vluncasu/power-supply-cases/cases/README.md

# Enclosure files

| Case | Supply | Print files |
|---|---|---|
| [Delta iMac 27″ Late 2015 Power Supply](imac-27-5k-2015/) | Delta ADP-300AF T · iMac 27-inch Retina 5K (Late 2015) | [STL and 3MF](imac-27-5k-2015/print/) |
| [AURA S-60-12](aura-s60/) | Metal S-60-12 · 86 × 58.02 × 33.02 mm STEP reference | [STL and 3MF](aura-s60/print/) |
| [AURA Compact 160](aura-compact-160/) | Metal housing · 110 × 98–100 × 35–36 mm photographic estimate | [STL and 3MF](aura-compact-160/print/) |
| [Suncronizer](suncronizer/) | Solar tracker demo · 104 × 57–58 × 26 mm supply and separate DC converter | [STL and 3MF](suncronizer/print/) |

[View all assembly galleries and print instructions on the project home page](../README.md)
