vluncasu/power-supply-cases/cases/aura-s60/renders/interior.png

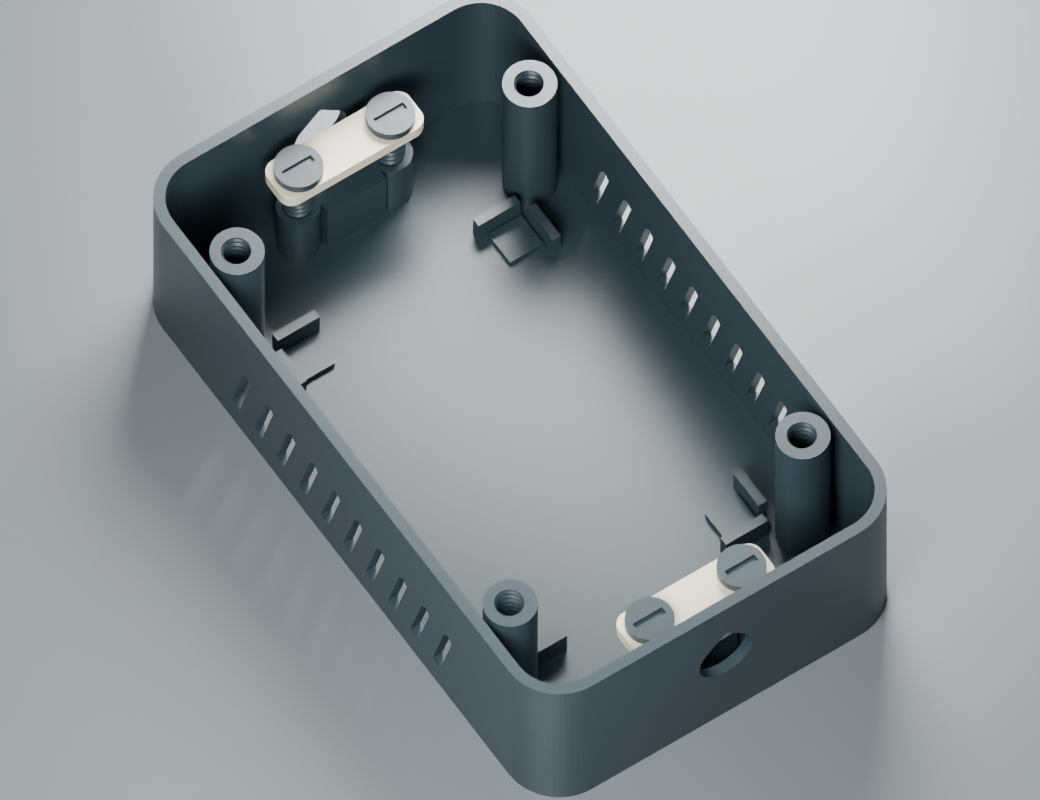
cases/aura-s60/renders/interior.png
