vluncasu/power-supply-cases/cases/aura-compact-160/cad/cable-clamp.step

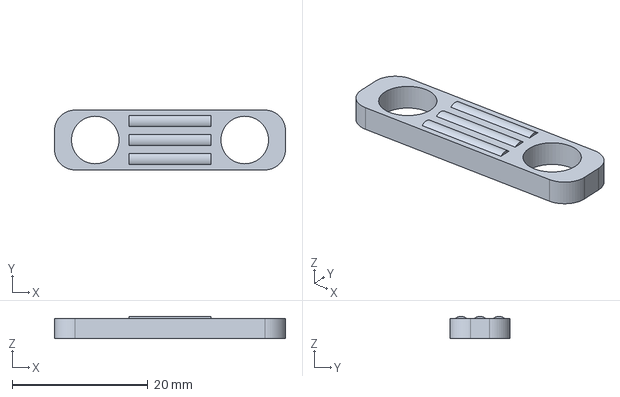
[picture p35: CAD file, 2026-11-08]
cases/aura-compact-160/cad/cable-clamp.step
34.0 x 8.80 x 3.30 mm
