vluncasu/power-supply-cases/cases/aura-compact-160/print/plates/02-white-9.3mf

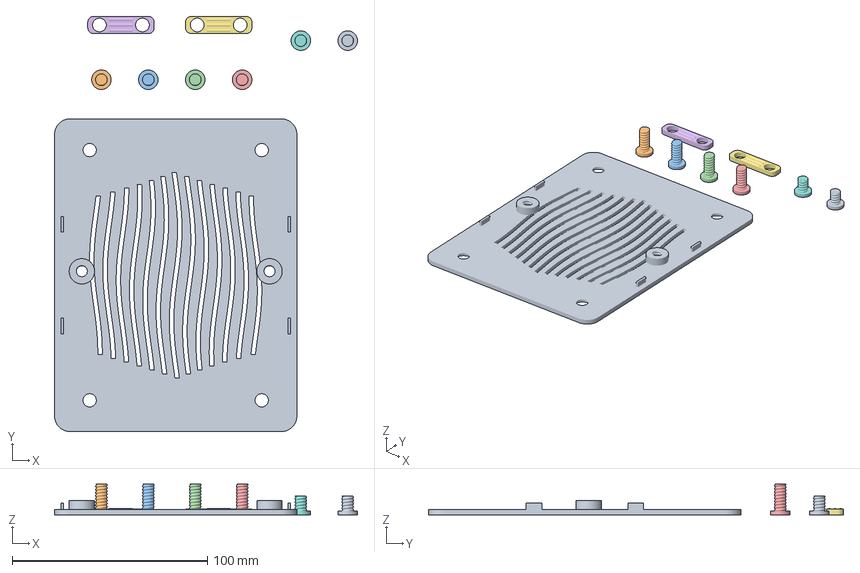
[picture p36: CAD file, 2026-11-08]
cases/aura-compact-160/print/plates/02-white-9.3mf
155.0 x 212.4 x 15.8 mm
02_WHITE_wave_lid_x1
03_WHITE_closure_x4 x 4
04_WHITE_cable_clamp_x2 x 2
06_WHITE_housing_pressure_x2 x 2
