vluncasu/power-supply-cases/cases/aura-compact-160/print/stl/black/01_body_x1.stl

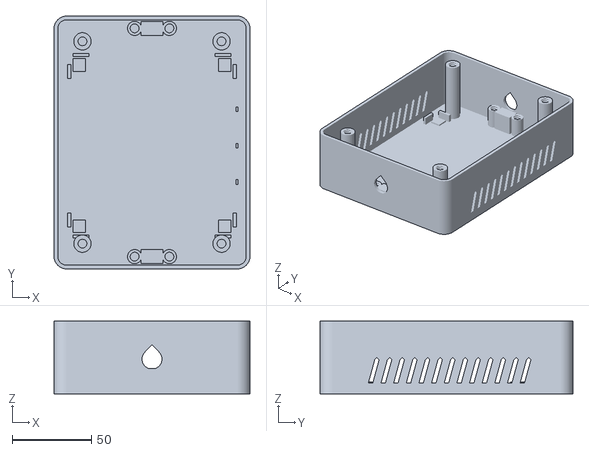
[picture p37: CAD file, 2026-11-08]
cases/aura-compact-160/print/stl/black/01_body_x1.stl
124.0 x 160.0 x 46.0
