vluncasu/power-supply-cases/cases/aura-s60/cad/lid.step

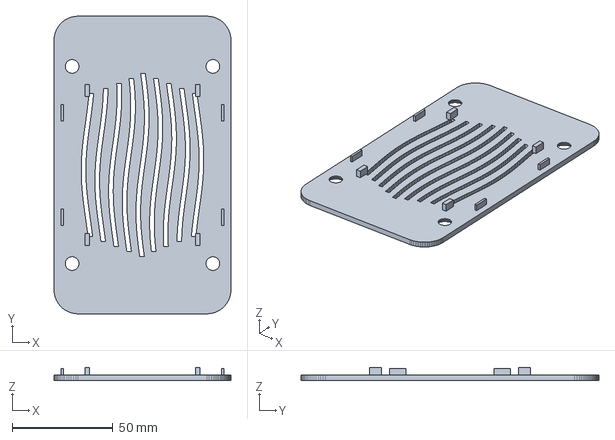
[picture p38: CAD file, 2026-11-08]
cases/aura-s60/cad/lid.step
88.0 x 148.0 x 6.60 mm
