vluncasu/power-supply-cases/cases/aura-s60/print/plates/02-ivory-7.3mf

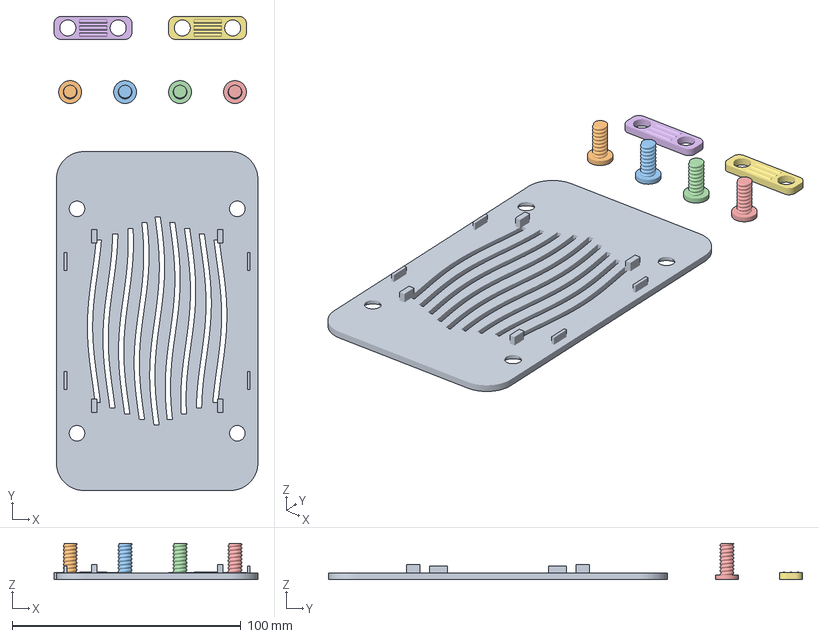
[picture p39: CAD file, 2026-11-08]
cases/aura-s60/print/plates/02-ivory-7.3mf
89.0 x 207.0 x 15.8 mm
02_IVORY_wave_lid_x1
03_IVORY_closure_x4 x 4
04_IVORY_cable_clamp_x2 x 2
