vluncasu/power-supply-cases/cases/aura-s60/print/stl/graphite/01_body_x1.stl

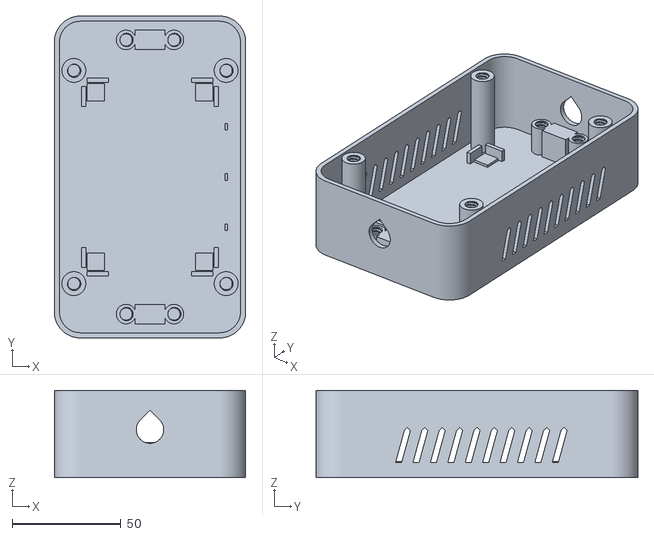
[picture p40: CAD file, 2026-11-08]
cases/aura-s60/print/stl/graphite/01_body_x1.stl
88.0 x 148.0 x 40.0
