vluncasu/power-supply-cases/cases/imac-27-5k-2015/cad/lid.step

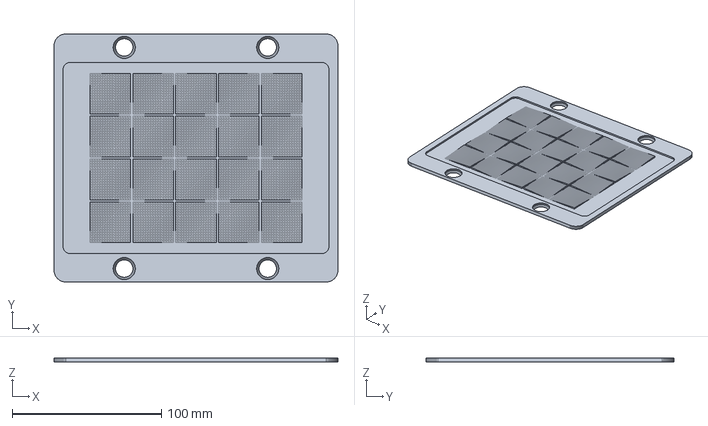
[picture p41: CAD file, 2026-11-08]
cases/imac-27-5k-2015/cad/lid.step
190.0 x 166.0 x 3.00 mm
