vluncasu/power-supply-cases/cases/imac-27-5k-2015/print/plates/01-graphite-13.3mf

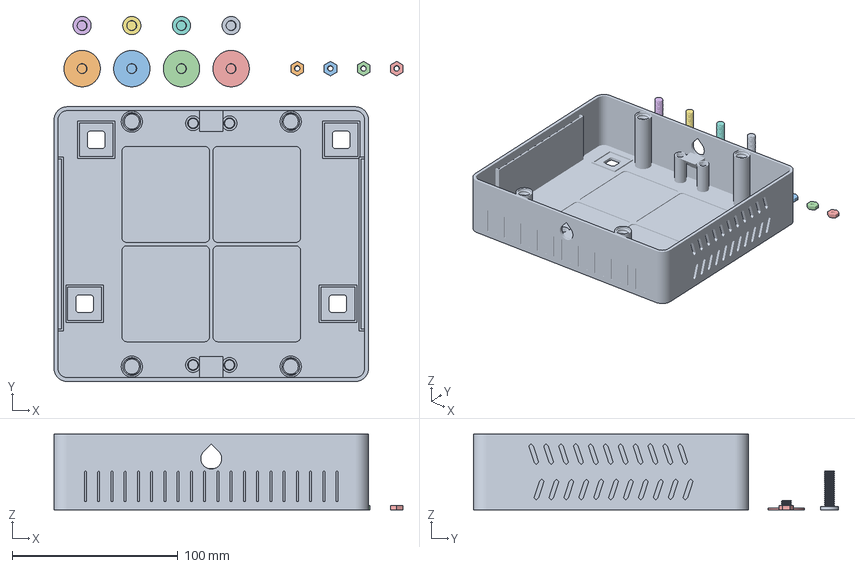
[picture p42: CAD file, 2026-11-08]
cases/imac-27-5k-2015/print/plates/01-graphite-13.3mf
210.8 x 220.5 x 45.8 mm
01_SLIM_BASE
05_MOUNT_LOCK_FOOT_x4 x 4
08_CABLE_CLAMP_SCREW_x4 x 4
06_PCB_NUT_x4 x 4
