vluncasu/power-supply-cases/cases/imac-27-5k-2015/print/stl/ivory/07_cable-clamp_x2.stl

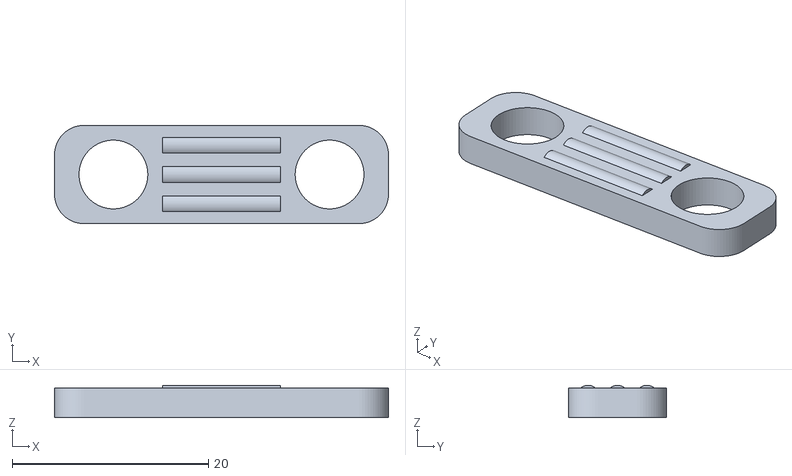
[picture p43: CAD file, 2026-11-08]
cases/imac-27-5k-2015/print/stl/ivory/07_cable-clamp_x2.stl
34.0 x 10.0 x 3.30
