vluncasu/power-supply-cases/cases/suncronizer/print/plates/02-green-7.3mf

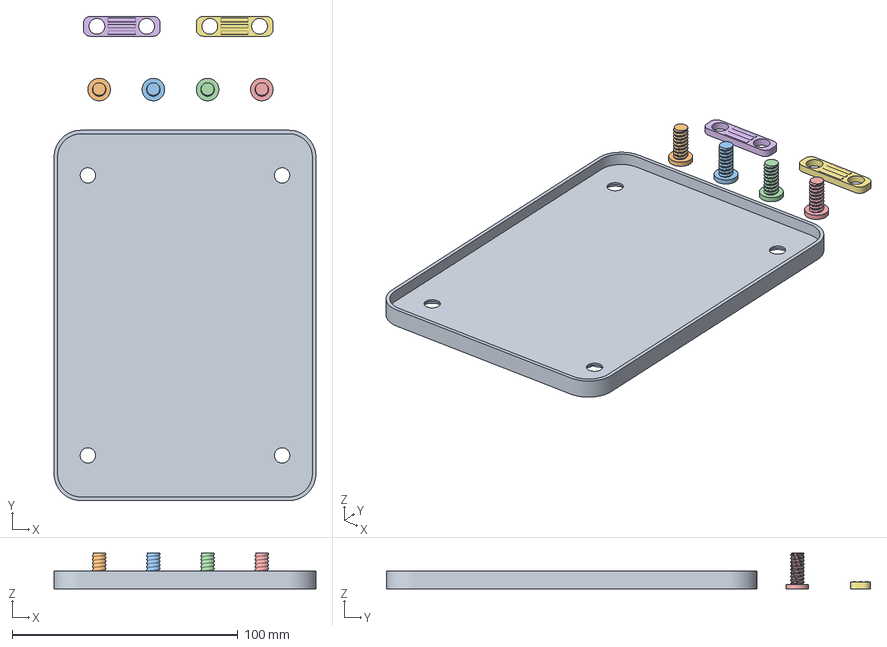
[picture p44: CAD file, 2026-11-08]
cases/suncronizer/print/plates/02-green-7.3mf
116.0 x 214.4 x 15.8 mm
02_GREEN_solar_cap_x1
03_GREEN_closure_x4 x 4
04_GREEN_cable_clamp_x2 x 2
