vluncasu/power-supply-cases/cases/suncronizer/print/stl/black/01_body_x1.stl

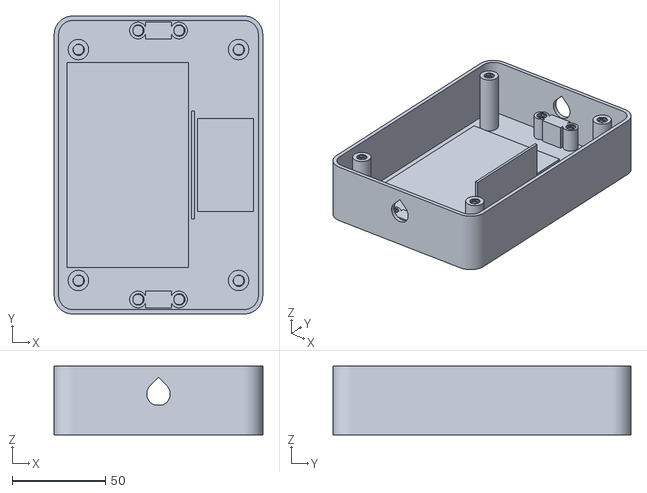
[picture p45: CAD file, 2026-11-08]
cases/suncronizer/print/stl/black/01_body_x1.stl
112.0 x 160.0 x 37.0
