vluncasu/power-supply-cases/cases/aura-compact-160/cad/lid.step

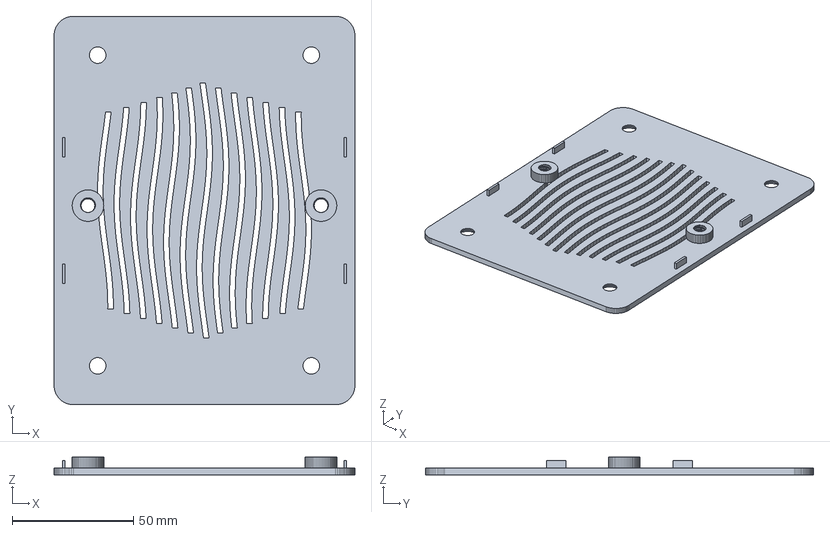
[picture p46: CAD file, 2026-11-08]
cases/aura-compact-160/cad/lid.step
124.0 x 160.0 x 7.40 mm
