vluncasu/power-supply-cases/cases/aura-compact-160/print/plates/01-black-5.3mf

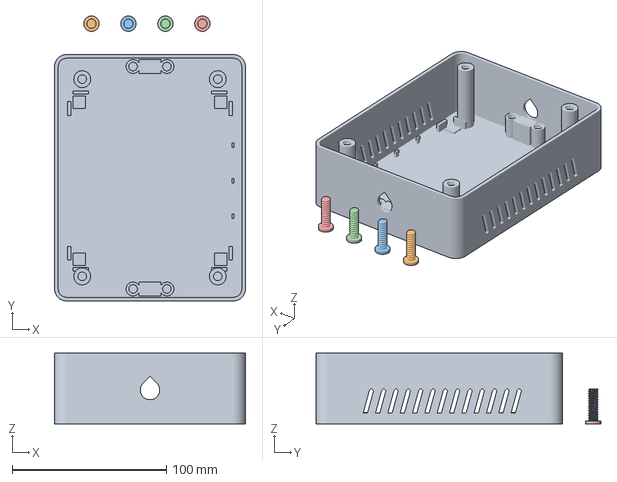
[picture p47: CAD file, 2026-11-08]
cases/aura-compact-160/print/plates/01-black-5.3mf
124.0 x 185.0 x 46.0 mm
01_BLACK_body_x1
05_BLACK_clamp_screw_x4 x 4
