vluncasu/power-supply-cases/cases/aura-s60/print/plates/01-graphite-5.3mf

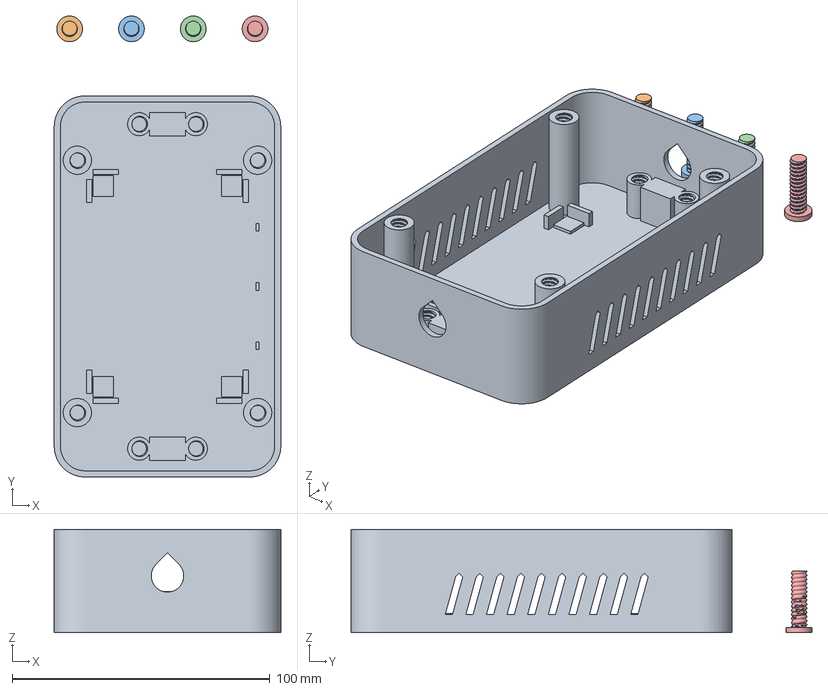
[picture p48: CAD file, 2026-11-08]
cases/aura-s60/print/plates/01-graphite-5.3mf
88.0 x 179.0 x 40.0 mm
01_GRAPHITE_body_x1
05_GRAPHITE_clamp_screw_x4 x 4
