vluncasu/power-supply-cases/cases/imac-27-5k-2015/print/plates/02-ivory-11.3mf

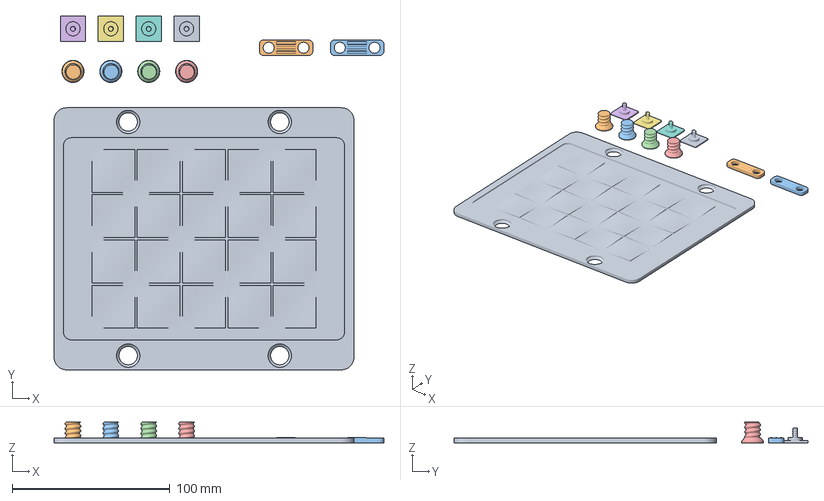
[picture p49: CAD file, 2026-11-08]
cases/imac-27-5k-2015/print/plates/02-ivory-11.3mf
209.0 x 224.0 x 13.0 mm
02_SLIM_LID_exterior_up
03_CLOSURE_SCREW_x4 x 4
04_XY_MOUNT_x4 x 4
07_CABLE_CLAMP_x2_print_flat_side_down x 2
