vluncasu/power-supply-cases/cases/imac-27-5k-2015/print/stl/ivory/04_xy-pcb-support_x4.stl

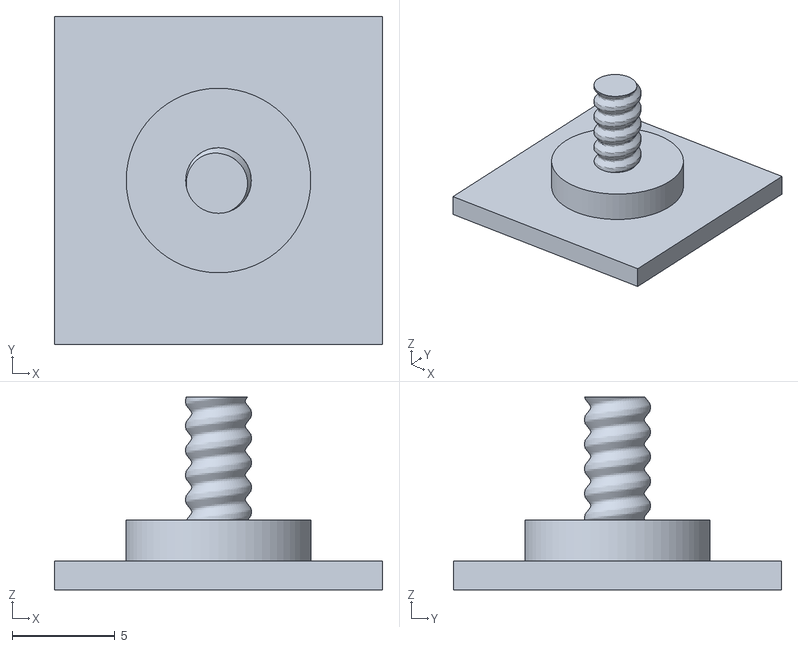
[picture p50: CAD file, 2026-11-08]
cases/imac-27-5k-2015/print/stl/ivory/04_xy-pcb-support_x4.stl
16.0 x 16.0 x 9.40
