vluncasu/power-supply-cases/cases/suncronizer/cad/lid.step

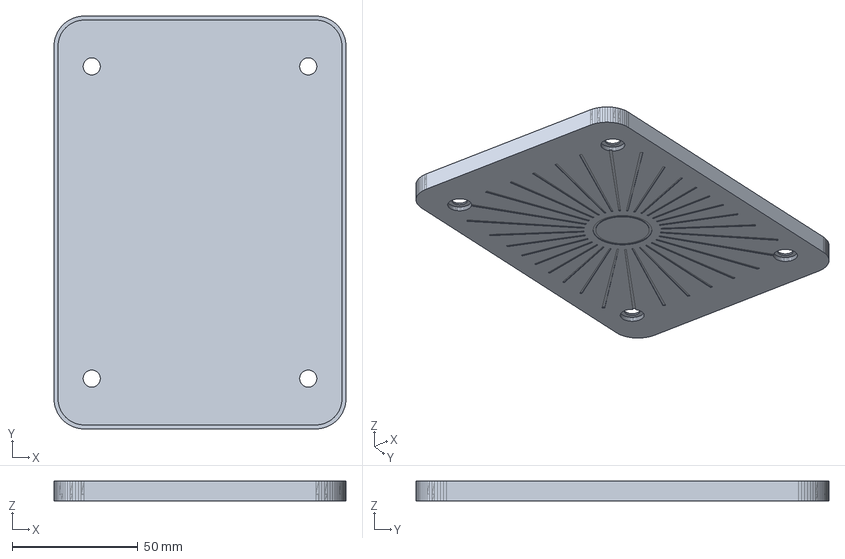
[picture p51: CAD file, 2026-11-08]
cases/suncronizer/cad/lid.step
116.0 x 164.0 x 7.80 mm
