vluncasu/power-supply-cases/cases/suncronizer/print/plates/01-black-5.3mf

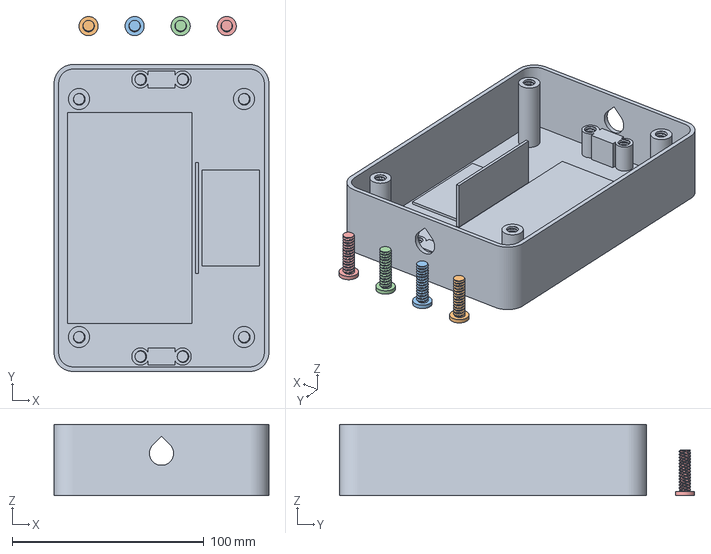
[picture p52: CAD file, 2026-11-08]
cases/suncronizer/print/plates/01-black-5.3mf
112.0 x 185.0 x 37.0 mm
01_BLACK_body_x1
05_BLACK_clamp_screw_x4 x 4
