vluncasu/power-supply-cases/cases/imac-27-5k-2015/print/stl/graphite/05_locking-foot_x4.stl

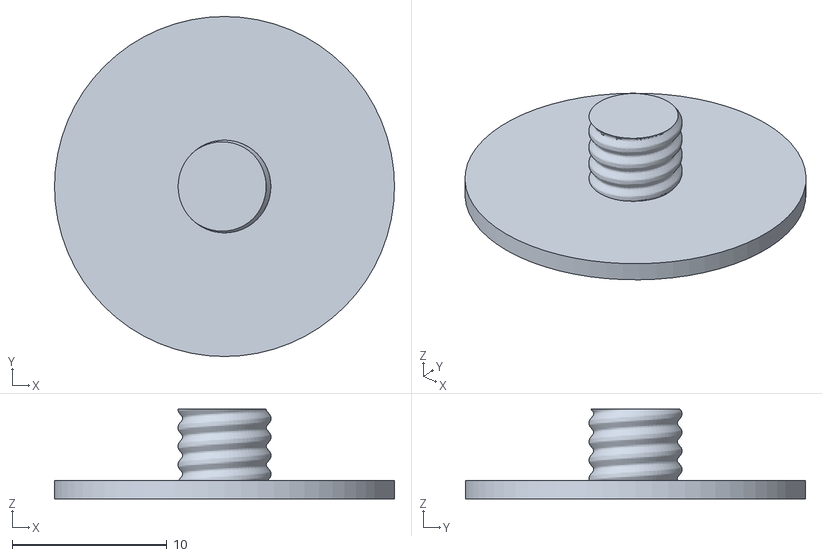
[picture p53: CAD file, 2026-11-08]
cases/imac-27-5k-2015/print/stl/graphite/05_locking-foot_x4.stl
22.0 x 22.0 x 5.80
