vluncasu/power-supply-cases/cases/imac-27-5k-2015/print/stl/graphite/01_base_x1.stl

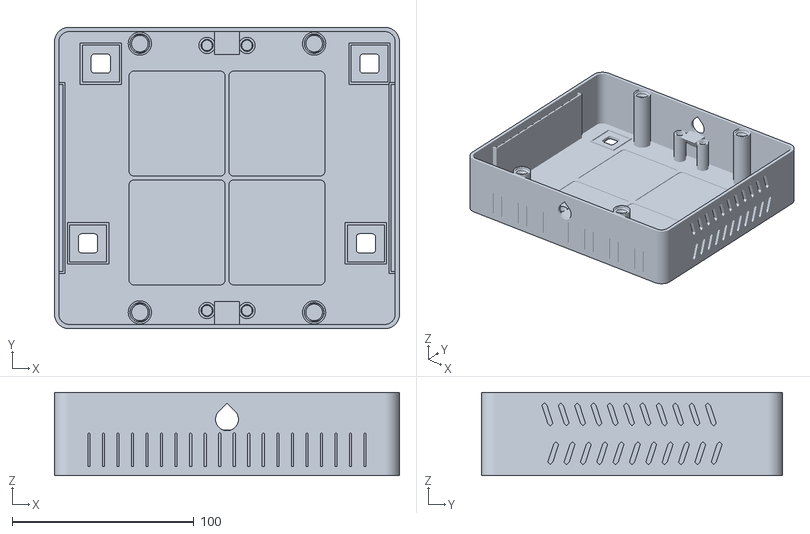
[picture p54: CAD file, 2026-11-08]
cases/imac-27-5k-2015/print/stl/graphite/01_base_x1.stl
190.0 x 166.0 x 45.8
