vluncasu/power-supply-cases/(list of files, cad)

Other CAD files:
cases/suncronizer/cad/cable-clamp.step
cases/suncronizer/print/stl/green/04_cable-clamp_x2.stl
cases/aura-compact-160/print/stl/white/04_cable-clamp_x2.stl
cases/aura-s60/cad/cable-clamp.step
cases/aura-s60/print/stl/ivory/02_wave-lid_x1.stl
cases/imac-27-5k-2015/cad/cable-clamp.step
cases/suncronizer/print/stl/green/02_solar-lid_x1.stl
cases/aura-compact-160/print/stl/white/02_wave-lid_x1.stl
cases/imac-27-5k-2015/print/stl/ivory/02_relief-lid_x1.stl
cases/aura-compact-160/cad/assembly.blend
cases/aura-compact-160/cad/cable-clamp.FCStd
cases/aura-compact-160/cad/edit-parts.blend
cases/aura-compact-160/print/stl/black/05_clamp-screw_x4.stl
cases/aura-compact-160/print/stl/white/03_lid-screw_x4.stl
cases/aura-compact-160/print/stl/white/06_hold-down-screw_x2.stl
cases/aura-s60/cad/cable-clamp.FCStd
cases/aura-s60/cad/edit-parts.blend
cases/aura-s60/cad/parts.blend
cases/aura-s60/print/stl/graphite/05_clamp-screw_x4.stl
cases/aura-s60/print/stl/ivory/03_lid-screw_x4.stl
cases/imac-27-5k-2015/cad/assembly.blend
cases/imac-27-5k-2015/cad/cable-clamp.FCStd
cases/imac-27-5k-2015/cad/edit-parts.blend
cases/imac-27-5k-2015/print/stl/graphite/06_pcb-nut_x4.stl
cases/imac-27-5k-2015/print/stl/graphite/08_clamp-screw_x4.stl
cases/imac-27-5k-2015/print/stl/ivory/03_lid-screw_x4.stl
cases/suncronizer/cad/assembly.blend
cases/suncronizer/cad/cable-clamp.FCStd
cases/suncronizer/cad/edit-parts.blend
cases/suncronizer/print/stl/black/05_clamp-screw_x4.stl
cases/suncronizer/print/stl/green/03_lid-screw_x4.stl
