vluncasu/power-supply-cases/(commit log)

2026-11-08 Publish four printable power supply cases with CAD, dimensional references and print plates
    [01-black-5.3mf, 01-graphite-13.3mf, 01-graphite-5.3mf, 01_base_x1.stl, 01_body_x1.stl, 02-green-7.3mf, 02-ivory-11.3mf, 02-ivory-7.3mf]
2026-11-08 Publish English P1S guides and four-angle assembly galleries for all enclosures
    [01-black-5.3mf, 01-graphite-13.3mf, 01-graphite-5.3mf, 02-green-7.3mf, 02-ivory-11.3mf, 02-ivory-7.3mf, 02-white-9.3mf, assembly.blend]
2026-11-08 Preserve binary CAD and print files
2026-11-08 Check STL geometry and P1S plate layouts
2026-11-08 Explain plate coordinates and BOM checks
2026-11-08 Guide P1S setup and print orientation
2026-11-08 Index the four enclosure kits
2026-11-08 Record enclosure file checksums
2026-11-08 Show every assembly and print kit on the home page
2026-11-08 Verify each enclosure directory
2026-11-08 Distribute editable case layouts, lid solids and parametric clamps
    [cable-clamp.FCStd, cable-clamp.step, edit-parts.blend, lid.step]
2026-11-08 Lead with open enclosures and document the iMac fastening assemblies
2026-11-08 Dimension the Delta board mounts and enclosure clearance section
2026-11-08 Show the Delta iMac power supply case and hardware directly from CAD
